yahfou/Automated-Transport-Line-Using-uArm-/white_board.jpg

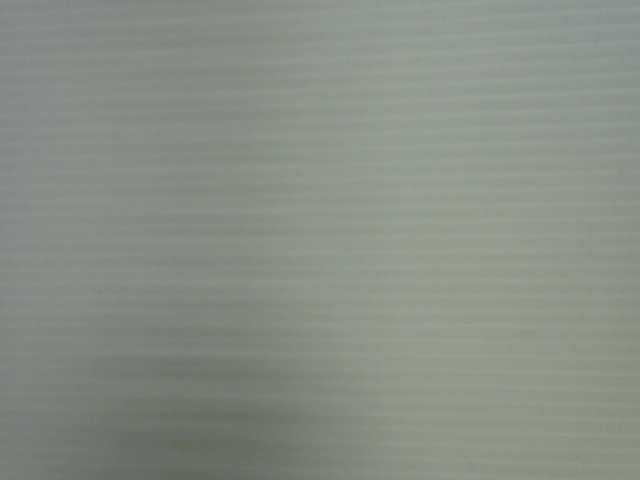
white_board.jpg
